Project-Aurora/Project-Aurora/(commit log)

2016-04-03 Adding Footprint Librarys
2016-04-03 Optimised Routing of Ground Trace
    [Project-Aurora.kicad_pcb]
2016-04-04 Prevented potential Ground loop
    On the Shielding of the USB Connecor
    [Project-Aurora.kicad_pcb]
2016-04-04 Clean up LED-Schematics
    Luckily I didn't make any mistakes in the first run.
    (Unless I made the same Mistake twice)
    [LED1A.sch, LED1B.sch, LED2A.sch, LED2B.sch]
2016-04-04 Added Fiducials, i2c Testpoints and a Filter-Cap
    Fiducials: 4 Two-Sided feducials in the Corners, 4 Feducials on the Back near the ICs (these might be Overkill)
    i2c Testpoints: Makes debugging less of a hassle, also tuned track-lengths of SCL and SDA
    Filter-Cap: Supposed to prevent high-pitched buzzing during load
    [Project-Aurora.kicad_pcb, Project-Aurora.sch]
2016-04-05 Cleaned up Schematic and Libraries
2016-04-05 Forgot some Stuff in the last Commit
    [Project-Aurora.kicad_pcb, Project-Aurora.sch]
2016-04-05 Picked more appropriate i2c Debug Port
    [Project-Aurora.kicad_pcb, Project-Aurora.sch]
2016-04-07 Switched from using a Dedicated one to the MCUs integrated Voltage Regulator for 3.3V. The LED-Drivers are now using 5V.
    [Project-Aurora.kicad_pcb, Project-Aurora.sch]
2016-04-08 Cleaned up some Routing Stuff.
    [Project-Aurora.kicad_pcb, Project-Aurora.sch]
2016-04-08 Properly named Case Ground.
    [Project-Aurora.kicad_pcb, Project-Aurora.sch]
2016-04-08 Removed References to unused Librarys.
    [Keymatrix.sch, LED1A.sch, LED1B.sch, LED2A.sch, LED2B.sch]
2016-04-11 Did some visual cleanup.
    [Keymatrix.sch, LED1A.sch, LED1B.sch, LED2A.sch, LED2B.sch, Project-Aurora.kicad_pcb, Project-Aurora.sch]
2016-04-12 Added Debug-Port
    In order to avoid buying the JLink Needle.
    [Project-Aurora.kicad_pcb, Project-Aurora.sch]
2016-06-10 Switched to a different USB Port and 100uF Cap
    also added a USB-Debug Header and did some cleanup
    [LED1A.sch, LED1B.sch, LED2A.sch, LED2B.sch, Project-Aurora.kicad_pcb, Project-Aurora.sch]
2016-06-11 Add proper Reference to Footprint Libraries
